prototypefund/psylink/src/data/photo.jpg

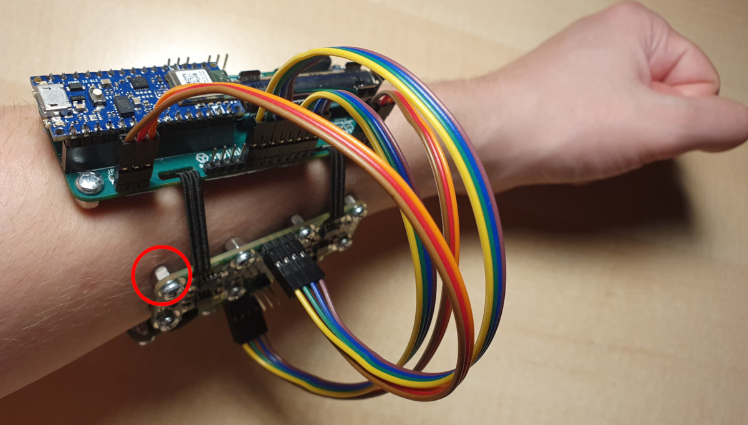
src/data/photo.jpg
