prototypefund/psylink/schematics/electrode_module3.3/README.md

# PsyLink Electrode Module 3.3

Front Side

This board is designed to be worn on a limb and measures voltages on 8 electrodes, does basic analog processing, and outputs 4 cleaned and amplified signals destined for the analog pins of the PsyLink power module 4.X.

The processing of the signal is the following, implemented 4 times on the circuit to produce 4 output signals:

    Electrode 1 -> Passive Highpass -.
                                      }==> Difference -> Amplifier (251x) -> Output Signal
    Electrode 2 -> Passive Highpass -'

# Overview

- Part ID: ["b3.2"](https://psylink.me/b3.2/)
- Circuit ID: ["10.4"](https://psylink.me/c10.4/)
- Dimensions: 70 x 25mm
- Finalized on: 2023-06-16
- Tested: Yes
- Bill of materials: [LibreOffice .ods file](https://psylink.me/tables/bom_p10.ods)
- Components of interest:
    - [INA128](https://www.ti.com/product/INA128) Instrumentation Amplifier [(datasheet)](https://www.ti.com/lit/ds/symlink/ina128.pdf)
    - [(091723) DIN 917, A2 stainless steel, M3 dome nuts](https://www.schraubenhimmel.de/muttern/hutmuttern/niedrige-form/21596/din-917-a2-m-3-hutmuttern-niedrige-form), as electrodes
    - [DIN 7985 A2 M3x4 screws](https://www.schraubenhimmel.de/schrauben/linsenkopf/metrisch-kreuzschlitz/31664/din-7985-edelstahl-a2-m-3x4-linsenschrauben-mit-kreuzschlitz-h)
- Known bugs:
    - Excessive interference on the trace between "U2" and "J3" ("out2"), resulting in a disturbed signal 2.  This mostly disappears when the module is pressed firmly onto the skin.

# Main Features

- 8 Input Signals from screw-mounted electrodes on EL1-EL8 (e.g. [M3 dome nuts of A2 stainless steel](https://www.schraubenking.at/M3-Hutmutter-DIN1587-Edelstahl-A2-P002263)
- 4 Output Signals on J3, cleaned and amplified, between 0V and V+ (usually 5V)
- Differential amplification of the signals with a gain of 251x using [INA128](https://www.ti.com/product/INA128) Instrumentation Amplifiers
- High-pass filtering using a passive highpass filter with a cut-off frequency of below 1.6Hz
- Signals (after high-pass filtering) are pulled towards Vref via a 1MOhm resistor to avoid drifting of the signal away from the center
- Requires a power supply on either J1 (or J2).
    - V+: 5V
    - Vref: 2.5V (must be connected to the ground electrode touching the skin)
    - GND: 0V
- Supports daisy-chaining the power supply to another electrode module via J2 (or J1 if you used J2 for the power input already)
- Supports plugging in external electrodes via dupont connectors on pins EX1-EX8, though it is advisable to keep the cable to the electrodes as short as possible (<10cm)
- Provides mounting points for 8 dome nuts (e.g. [M3 dome nuts of A2 stainless steel](https://www.schraubenking.at/M3-Hutmutter-DIN1587-Edelstahl-A2-P002263)) that act as ground electrode and spacers between the board and the skin
- Provides solder jumpers JP1-JP8 (closed by default) to disable the built-in screw-mounted electrodes EL1-EL8 in favor of external electrodes on EX1-EX8, so that you can wear the board on the skin without disturbing the external electrode signals with the built-in electrodes.

# IMPORTANT ASSEMBLY INSTRUCTIONS

- Before soldering on any through-hole components, their pins must be shortened with e.g. wire cutters so that they do not extend out of the board on the bottom side, to avoid scratching the skin
- The "Vref" pin must be connected to a ground electrode on the skin.  The standard method is:
    1. connect the Vref pin of the electrode module with the Vref pin of the power module
    2. wear the power module on the skin so that the screws are firmly touching the skin
    3. ensure that one of the screws is actually enabled as ground electrode by reading the assembly instructions of the power module

# PCB Images

Front Side

Back Side

# Circuit Image

Circuit

# Changelog

Electrode Module 3.3:

- Fixed aggressive filtering of signals by changing passive highpass filter capacitors C1-C8 from 100pF to 100nF.
- Reduced gain from 501x back down to 251x, since the highpass filter fix strenghened the signal

Electrode Module 3.2:

- Gain resistors R9, R11, R12 have been reduced from 1000 Ohms to 100 Ohms, raising the gain tenfold, from 51x to 501x.
- Gain resistor R10 was only reduced to 200 Ohms, raising the gain to only 251x. This was done to offset an interference bug along the out2 trace.  Once this is fixed, the resistance should be set to equal that of R9/R11/R12 once again.
- JP1-JP8 are now closed by default, to save time during assembly
- Moved EX1 closer to EX5 and EX4 closer to EX8, so that two 2-pin-headers can be used instead of four 1-pin headers
- Longer solder pads on U1-U4 for easier hand-soldering
- Improved labels, added PsyLink logo

Electrode Module 3.1:

- Wider contacts on the electrode mounting points
- Added solder jumpers JP1-JP8 that disconnect the built-in electrodes to enable wearing the module on the skin while using external electrodes without the built-in electrodes disturbing the external signal
- Breaking ground loop on the bottom side of the board by adding a hole in the circular filled area

Electrode Module 3.0:

- Redesigned from scratch
- Reduced number of power input (or daisy-chain) connectors from 3 to 2
- Increased number of amplifier circuits from 1 to 4
- Added holes for rubber bands on the sides, compatible with corresponding power module.
- Added slots for screw-mounted electrodes
- Split circuit diagram into separate electrode module and power module circuits
- Notably, the amplifier circuit, incl. gain, was not changed
- New dimensions: 70 x 25mm

Electrode Module 2:

- Added pin labels
- Thicker traces

Electrode Module 1:

- Initial version
- Calculates the difference between two voltages after a passive highpass with a cut-off frequency of below 1.6kHz (Warning: this is a bug, should have been 1.6Hz. Fix this by changing 100pF capacitors to 100nF).
- Dimensions: 20 x 16mm
