prototypefund/psylink/schematics/electrode_module4/README.md

# PsyLink Electrode Module 4.0

Front Side

Designed by AntonX.

**Work in progress.  For the time being, please use electrode module 3.X instead.**
