prototypefund/psylink/archive/7_python/psylink/README.md

A python library for interfacing with the PsyLink device
