prototypefund/psylink/src/data/psylink.png

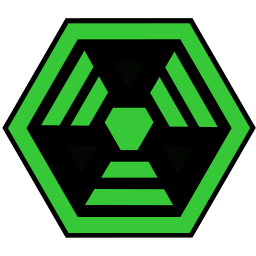
src/data/psylink.png
