prototypefund/psylink/schematics/power_module4.2/assembly_BOM.csv

ID | Designator | Footprint | Quantity | Value | LCSC Part #
1 | C1, C10, C11, C4, C5, C6, C8, C9 | C_1206_3216Metric_Pad1.42x1.75mm_HandSolder | 8 | 10uF | C13585
2 | C2, C3, C7 | C_1206_3216Metric_Pad1.42x1.75mm_HandSolder | 3 | 100uF | C15008
3 | L1 | L_1210_3225Metric_Pad1.42x2.65mm_HandSolder | 1 | 10uH | C395029
4 | R1 | R_0805_2012Metric_Pad1.15x1.40mm_HandSolder | 1 | 1M/1% | C17514
5 | R2, R3, R4 | R_0805_2012Metric_Pad1.15x1.40mm_HandSolder | 3 | 110K/1% | C17422
6 | U1 | Texas_R-PDSO-G6 | 1 | TPS61220DCK | C15421
7 | U2 | SOT-23-5 | 1 | LM321 | C471859
