prototypefund/psylink/src/data/spinner-step1.png

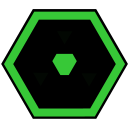
src/data/spinner-step1.png
