prototypefund/psylink/src/data/spinner-step2.png

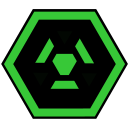
src/data/spinner-step2.png
