prototypefund/psylink/src/data/spinner-step3.png

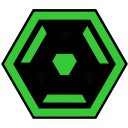
src/data/spinner-step3.png
