prototypefund/psylink/build.rs

fn main() {
    let config = slint_build::CompilerConfiguration::new()
        // .with_style("native".into());
        .with_style("fluent-dark".into());
    slint_build::compile_with_config("src/psylink.slint", config).unwrap();
}
