prototypefund/psylink/(commit log)

2023-08-24 schematics: add quick links to components of interest
2023-08-24 schematics: use english link rather than german
2023-08-24 schematics: add reference
2023-08-24 schematics: add/update details of electrode module 3.3
2023-08-24 schematics: wording
2023-08-24 schematics: amend changelog
2023-08-24 schematics: merge together different changelog categories
2023-08-24 schematics: extend and clarify changelogs
2023-08-24 schematics: add pictures at the top of readmes
2023-08-24 schematics: mention that the boards are designed to be worn on a limb
2023-08-24 schematics: typo
2024-01-08 add files for PCBWay order of power_module4.2
    [assembly_BOM.csv, assembly_positions.csv]
2024-01-08 add files for PCBWay order of electrode_module3.3
    [assembly_BOM.csv, assembly_positions.csv]
2024-05-04 add rust tool to scan for, and print MAC address of PsyLink devices
2024-05-04 print help if no arguments/commands are supplied
2024-05-09 implemented "print" command (with terrible error handling)
    [bluetooth.rs, firmware.rs, main.rs]
2024-05-09 add PrototypeFund to acknowledgements
2024-05-09 copy over another UUID constant from arduino code to rust
2024-05-15 implement finding psylink in GUI and printing its MAC address
2024-05-15 pass device out of the loop
2024-05-15 display raw numbers from psylink sensors
2024-05-24 implement decoding sample_count
2024-05-24 move constants based in arduino code into firmware module
2024-05-24 implement decoding samples
2024-05-30 document arduino dependency versions
2024-06-18 update screws/nuts in schematic READMEs
2024-07-25 add AnalogToBLE1.3, compatible with Arduino Nano 33 BLE (Sense) Rev2
2024-08-01 run PsyLink GUI from android entrypoint (bluetooth fails for now)
    [lib.rs]
2024-08-15 work on the calibration page
2024-08-15 tweak button handling
2024-08-15 add state machine for calibrator
2024-08-15 generate calibrator messages, move on to the next action
2024-08-15 integrate the Calibrator into the GUI
2024-08-15 decode gyroscope/accelerometer channels, display them in graph
2024-08-15 move Calibrator to calibration.rs
2024-08-15 add key bindings 1/2 to switch tabs
    [gui.rs]
2024-08-15 add Sample and Samples structs
2024-08-15 implement burn Dataset for PsyLink Samples
    [calibration.rs]
2024-08-16 refactor Calibrator/calibrationstate into CalibrationFlow
2024-08-16 add start/stop methods for CalibrationFlow
2024-08-16 assemble the training dataset during calibration flow
2024-08-16 replace LOOKBEHIND constant with SAMPLE_TIMESPAN
    [calibration.rs]
2024-08-16 add emojis to calibration instructions
2024-08-16 add simple "Train" button that triggers CalibController.train()
2024-08-16 reset CalibController.dataset when starting to calibrate
    [calibration.rs, gui.rs]
2024-08-16 `psylink print` doesn't need -v anymore to print anything
    [bluetooth.rs]
2024-08-18 add "Debug" button that writes the recorded dataset to a file
2024-08-19 rename output of "Save" button
2024-08-19 fix test dataset declaration
    [calibration.rs]
2024-08-19 fixed test dataset (had to transpose sample vector)
    [calibration.rs, gui.rs, lib.rs]
2024-08-19 fix training/validation dataset split ratio
    [calibration.rs]
2024-08-19 better button naming
2024-08-21 add buttons for infer, load model, stop inference
2024-08-22 grey out buttons when they're not usable
2024-08-22 proper tracking of time during calibration
2024-08-22 shorter calibration times
2024-08-22 huge performance improvement by enabling threads (duh)
2024-08-22 huge performance improvement by moving inference to another thread (duh)
2024-08-22 fix inference. works now, woohooo!!!
    [calibration.rs, gui.rs]
2024-08-23 add 1ms delay in inference thread
2024-08-23 properly quit inference thread when main window is closed
2024-08-23 switch to "fluent-dark" slint widget style
2024-08-23 set calibration in UI to false upon completion
2024-08-23 move plot rendering to separate thread
2024-08-23 print warnings about lost packets
2024-08-23 move ui changes to separate thread
2024-08-23 fix clock of calibrator
    [gui.rs]
2024-08-23 left-align ui buttons in signal tab
2024-08-26 add switches to toggle accelerometer/gyroscope
2024-08-26 protocol: if gyro/accel disabled, add zero values instead of nothing
2024-08-27 properly quit threads for networking and UI updates
2024-08-27 gui: replace spinnner with animated psylink logo
    [gui.rs]
2024-08-27 Revert "gui: simplify animation tick with slint built-in "animation-tick()""
    This reverts commit dca8a699e5c2625158796e782e6a5b8878d8231a.
    Because this creates weird delays when moving the mouse around
    [gui.rs]
2024-08-28 larger text for calibration instruction
2024-08-29 properly disconnect device on application quit
2024-08-29 gui: replace Arc::clone() with a simple .clone()
    [gui.rs]
2024-08-29 fakeinput: graceful handling of enigo initialization error
    [fakeinput.rs]
2024-08-29 gui: add statusbar showing #samples, connected?, calibrated?
2024-08-29 gui: better debug button positioning and labeling
2024-08-29 gui: implement "Save activity log" button
2024-08-29 gui: prevent redundant text changes
    [gui.rs]
2024-08-29 gui: grey out "Train" button if there are no samples to be trained on
2024-08-29 calibration: add comment
2024-08-30 gui: fix missing ModelConfig.num_classes update
    [calibration.rs, gui.rs]
2024-08-30 gui: prettier button arrangement in Signal tab
2024-09-01 disable "Predict" button when not connected
2024-09-01 move training to a separate thread
2024-09-01 gui: fix "Start calibration" button not working on the second time
    [gui.rs]
2024-09-01 gui: move "Activate {gyroscope,accelerometer}" switches to Dev Tools tab
2024-09-01 calibration: remove completed TODO comments
2024-09-01 gui: fix packet loss verbosity
    [gui.rs]
2024-09-04 gui: fix training (last-minute bug @ prototypefund demo day...)
    [gui.rs]
2024-09-04 change test-dataset/test-model to one with 3 keys for tuxkart steering
2024-09-04 gui: fix infinite calibration loop
    [gui.rs]
